SEAME-pt/See_Me_Flying/docs/sprints/README.md

---
title: Sprints Overview
---
# 🎯 Autonomous Drone — Sprints 

This document serves as the central planning and progress tracking guide for the Autonomous Drone project. It provides an overview of sprint objectives, timelines, and links to the documentation produced throughout the development process.

The project follows an iterative development approach, with each sprint lasting approximately two weeks.

## 🔗 Sprints

| Sprint | Period | Documentation |
| --- | --- | --- |
| **Sprint 0** — Onboarding & Baseline | 6 Oct – 16 Oct 2026  | [Sprint 0](./sprint_0.md) |
| **Sprint 1** | 19 Oct - 01 Nov 2026 | [Sprint 1](./sprint_1.md) |

## 🔗 Sprint Roadmap

### ✔️ Sprint 0 — Onboarding & Baseline

**Focus:** Development environment setup, Git workflow, ROS 2 fundamentals, team organization, and initial hardware teardown and analysis.

**Documentation:** [Sprint 0](./sprint_0.md)

### ⏳ Sprint 1 — To be defined

**Focus:** To be defined

**Documentation:** To be defined

---

*Project documentation is updated throughout each sprint.*

# Tags

#sprints
