SEAME-pt/See_Me_Flying/Sprint 2 Planning.pptx

## Sprint 2 Planning

SEE ME FLYING · TEAM 4 · SEA:ME 2.0

Reduce the gap between the simulation and the real drone

Sprint 2 Nov – 15 Nov 2026

Milestone 1 · Architecture, RT Control & Sim

Notes: This deck is about the features we finished in Sprint 1, not the issue count. Each feature slide says what it does, how we know it works, and which branch the code is on. The issue numbers are at the end.

## What will be done

SPRINT 2 Planning

- Add sensor values and delay
- Better CAD models

- Clean up old branches and merge ready to go features to main
- Start documentation for tests realized
- Improve on how documentation is made

- Test and improve ESP12 setup
- Better understanding of how INAV sends and receives information

- Build a tool that will receive and send everything INAV related
- Develop and implement better ways to test sensors

- Organize CI errors into folders by topic.
- Add CI tests that work with the simulation objectives other than the default previously defined.

-> Better simulation

-> Documentation and organize

-> Hardware

-> Firmware

-> Tests and CI

Notes: Six features came out of Sprint 1. The next six slides take them one at a time: what it does, how we checked it, and where the code is.

## Issues breakdown

SPRINT 2 Planning

19issues

60 sub-issues
