SEAME-pt/See_Me_Flying/.assets/diagram.png

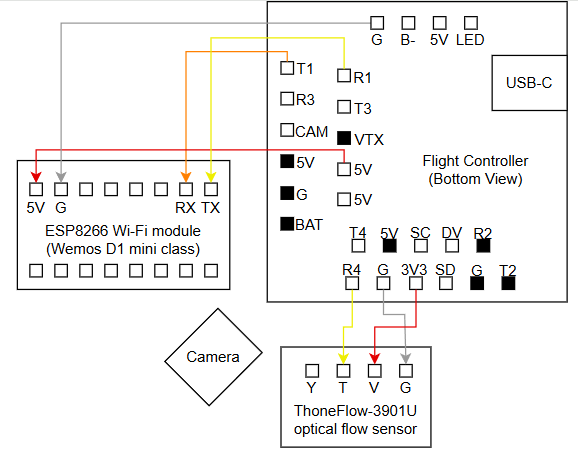
.assets/diagram.png
