SEAME-pt/See_Me_Flying/docs/3D Print Files/holder.stl

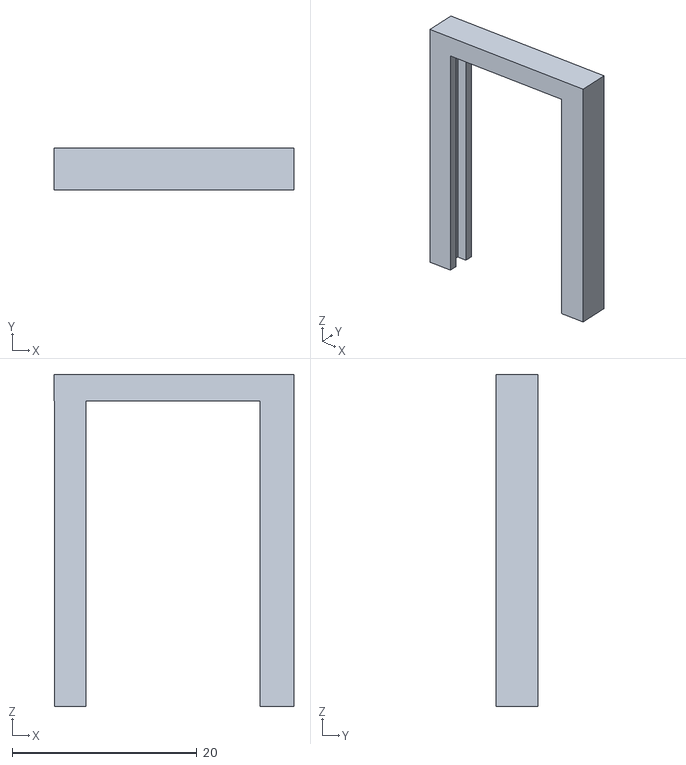
[picture p2: CAD file, 2026-10-22]
docs/3D Print Files/holder.stl
26.0 x 4.56 x 36.0
