SEAME-pt/See_Me_Flying/roomodel/room.stl

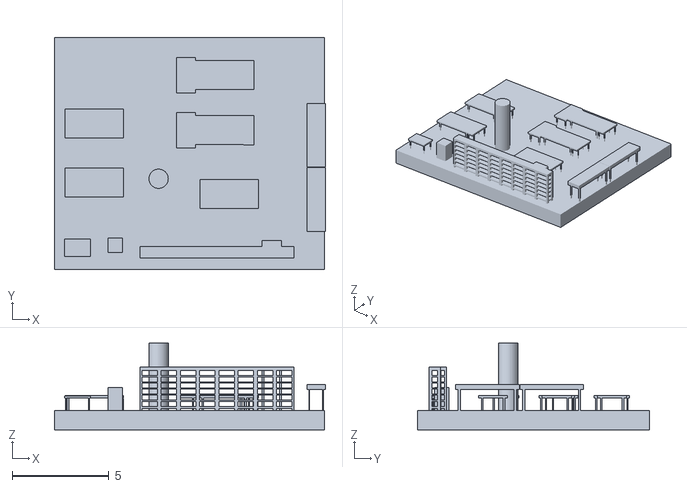
[picture p3: CAD file, 2026-11-13]
roomodel/room.stl
14.0 x 12.0 x 4.49
