SEAME-pt/See_Me_Flying/docs/3D Print Files/pmw3901.stl

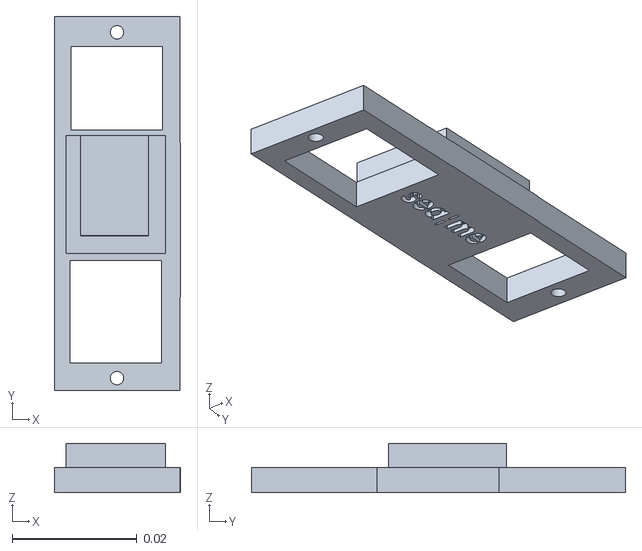
[picture p4: CAD file, 2026-10-22]
docs/3D Print Files/pmw3901.stl
0.0202 x 0.06 x 0.00789
