SEAME-pt/See_Me_Flying/docs/3D Print Files/box.stl

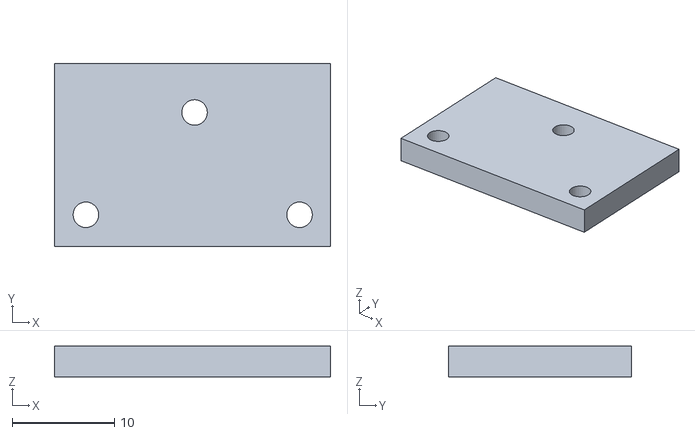
[picture p5: CAD file, 2026-10-22]
docs/3D Print Files/box.stl
27.0 x 17.9 x 3.00
