SEAME-pt/See_Me_Flying/(commit log)

2026-10-19 insert sprint 0 documentation
2026-10-23 Add RadioMaster Pocket teleop for the sim (source:=joy)
    - radio_teleop node: Pocket over USB as a joystick, arm switch as
    deadman, refuses to engage with the throttle off centre
    - sim.yaml: joy_node (radio selected by name) and radio_teleop
    parameters; joy_node inverts every Pocket axis, the signs undo it
    - container: /dev/input mounted with a cgroup rule for hotplug,
    input group via INPUT_GID, ros-jazzy-joy installed
    - fix setpoint_pub climb_speed (was 0.0, so circle mode never took off)
2026-10-23 Document the sim teleop stack and update the nodes doc
    - SIM_TELEOP.md: what changed, setup after pulling, how to fly with
    circle/keyboard/radio, parameters, failsafes, results, troubleshooting
    - README: source:= launch argument, radio_teleop, /fc/odom, NaN guard,
    body frame result, known issues brought up to date
    - GUIDE: pointer to SIM_TELEOP.md
2026-10-27 Established the connection between ROS 2 and the Rattler 2 camera
2026-10-27 Documentation for connection between ROS 2 and Rattle 2 camera
2026-10-27 Backups for the original Betaflight setup, and current INAV diff all
2026-10-27 Rewrote the README.md to reflect the current state of the project
2026-10-28 Added receiver ping script, and backups ELRS and custom INAV target - script for identifying the make/firmware of receiver - ELRS flashed on the receiver - CUSTOM INAV target for our ODDITYRCF7AIO dr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
2026-10-28 Documented battery tests and drone INAV accelometer calibration
2026-10-28 Documented Motor Software (Electronic Speed Controller) settings
2026-10-29 Add the mission node: takeoff, hold, circle, yaw and land on the rangefinder
    New package drone_mission (step 4 of PLAN.md), started with
    source:=mission. Height comes from fc/range, tilt-corrected, with a
    P controller in every airborne phase, so the X3's sag and the 15 cm
    drop in a yaw are gone. Touchdown is detected from the range or from
    "commanding down, not moving down". Losing the range hovers, then
    lands blind after 2 s; a takeoff that never reaches the target lands.
    The state machine is plain Python (logic.py) with 15 tests against a
    toy drone. Flown in headless Gazebo: settled at 1.20 m, held
    1.197-1.203 m through the circle and a full turn, landed by itself.
    Docs: README mission s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
2026-10-29 Add drone_interfaces, mission actions, and fc_bridge arm/hold/status
    Step 5 of PLAN.md. New package drone_interfaces: FcStatus, and the
    Takeoff, Goto and Land actions. fc_bridge gets fc/arm (drives the sim
    enable topic, starts armed), fc/hold (zero whatever arrives) and
    fc/status. mission becomes three action servers, one goal at a time,
    holding height between goals: Goto is relative to the drone's heading
    because flow position drifts, Land preempts anything and can't be
    cancelled, Takeoff arms and a Land disarms. demo_flight (started by
    source:=mission unless demo:=false) flies takeoff, a 1 m square, land.
    Fixed after manual runs: Ctrl-C hung mission when there was no /clock
    (it keeps rclp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
2026-10-30 Add safety_manager: radio > manual > mission, with a takeover switch
    Step 6 of PLAN.md. New package drone_safety: safety_manager is the only
    publisher of /fc/setpoint_velocity. Each source publishes on its own
    topic (/cmd/radio, /cmd/manual, /cmd/mission); the highest-priority one
    that published in the last 0.3 s is forwarded, and the active source is
    latched on safety/active_source. The rule (arbiter.py) is plain Python
    with 9 tests. It replaces the watchdog in the sim launch.
    mission listens to safety/active_source: losing control aborts the goal
    and goes quiet (state overridden); control back holds where the pilot
    left it, or stays grounded. 6 more logic tests.
    The radio always runs in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
2026-10-30 Prepare fc_bridge for the real drone; only the radio arms
    Step 7 of PLAN.md. fc_bridge gets a backend parameter, sim or inav.
    inav is the stub for MSP to INAV through the ESP8266: same topics and
    services, sends nothing yet, refuses fc/arm, and has no Gazebo topics
    or enable, so nothing sim-only can reach the real drone. 3 launch tests.
    The sim now arms like the hardware: radio_teleop's arm switch (SA) arms
    and disarms through fc/arm, and off is a kill switch even in flight.
    Like INAV it won't arm with the throttle off centre or on a switch that
    was already on at start. The takeover switch hands over the sticks and
    no longer arms. mission (radio_arms) refuses Takeoff until armed, never
    arms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
2026-11-02 Add the sprint 2 plan for the ROS side
    Goal: ROS reads the real drone over Wi-Fi (MSP through the ESP8266), and
    we know the link's latency. Read-only, props off; items that need no
    hardware for when it's blocked.
2026-11-05 Adds drone_interfaces/msg/OpticalFlow, mirroring INAV's MSP2_INAV_OPTICAL_FLOW in ROS units (rad/s), for fc/optical_flow.
    - Sign convention documented in the message: flow_rate is written
    like a gyro rate, so (flow_rate - body_rate) is the motion part.
    Checked: colcon build and colcon test (135 tests, 0 failures).
2026-11-06 sim: add flow_model, synthetic optical flow from ground truth
2026-11-06 Made improvements to the optical flow, more like a real sensor - flow rate noise - noise and rounding off by default, sim.yaml activates - more tests in test_flow_model
2026-11-09 Record Wi-Fi round-trip runs in logs/measurements/wifi_rtt
    scripts/measure_wifi_rtt.py runs telemetry/latency_test.py unchanged and
    keeps each run in its own dated folder: the per-sample CSV, a summary in
    values.json and a line in history.csv, including the real request rate.
2026-11-09 sim: added flow_check and documented simulated sensors (ROS-10.2)
    flow_check turns fc/optical_flow and fc/range into a velocity, as INAV
    does, and every 2 s logs its error against /sim/ground_truth.
    SIM_SENSORS.md documents the simulated sensors, their parameters and
    sources, the flow sign convention, and how to repeat the pass.
    fixes #203
2026-11-10 Added ESP12 and Groundstation documentation and improved obsidian layout
2026-11-10 ROS-6 step A: MSP v2 framing and INAV decoders for fc_bridge (#135)
    A small library (fc_msp) for the inav backend, no ROS and no sockets:
    - msp.*: requests, CRC8 DVB-S2 and a stream parser. Only the nine read
    commands can be built; MSP_SET_RAW_RC and every other write is refused.
    The parser resyncs one byte past a damaged header, so a good reply that
    follows inside its claimed span is not lost, and skip_pending() releases
    the replies behind a header that will never complete.
    - inav_decode.*: decoders for API/variant/version, rangefinder, attitude,
    MSP2_INAV_STATUS, optical flow, analog and full local pose, in SI units
    but INAV's own axes. Layouts follow the INAV 9.1.0 source; wh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
2026-11-12 added .stl file of the room, no textures
2026-11-13 sim: estimator v1, fc/odom from flow, range and attitude
    fc/odom now comes from the simulated sensors instead of
    fc_bridge's noisy ground truth: velocity from optical flow x range,
    height from range x cos(tilt), position integrated by heading, and
    vertical speed as a least-squares slope over 0.6 s of heights.
    fc_bridge gets publish_odom (default true); sim.yaml sets it false and
    sim.launch.py starts the estimator.
    Checked: 11 new unit tests; side by side with ground truth, hover height
    within 2 cm, vertical speed within +-0.015 m/s, 4 m pass read 3% short
    (the flow's whole-degree rounding); mission Takeoff, Goto and Land all
    succeed on it.
2026-11-13 Add truth publisher for ground truth odometry
2026-11-13 Add flow_model and estimator nodes to launch
